ARK-Electronics/ARK_RTK_GPS/README.md

# DEPRECATED

This repository is no longer maintained. Its hardware files now live in [ark-hardware/ARK_RTK_GPS](https://github.com/ARK-Electronics/ark-hardware/tree/main/ARK_RTK_GPS).

Documentation: https://docs.arkelectron.com/products/gps/ark-rtk-gps
