ARK-Electronics/ARK_RTK_GPS/Hardware/Rev 3/ARK RTK GPS Rev 3 BOM.xlsx

LibRef | Designator | Quantity | Manufacturer | Mfr Part Number | Comment | Mfr Part Description | Footprint | Supplier | Supplier Part Number
30007 | C1, C2, C6, C19, C22, C23, C25, C27, C29, C32, C33, C34, C35 | 13 | Walsin Technology Corporation | 0402X104K250CT |  | CAP CER 0.1uF ±10% 25V X5R 0402 (1005 Metric) | CAP 0402/1005 | Digi-Key | 1292-1640-2-ND
30151 | C3, C5, C8, C17, C24, C30 | 6 | Murata | GRM155R61A225ME95D | 2.2uF | CAP CER 2.2uF ±20% 10V X5R 0402 (1005 Metric) | CAP 0402/1005 | Digi-Key | 490-10452-2-ND
30652 | C4, C13, C14, C20 | 4 | Samsung Electro-Mechanics | CL05A105KP5NNNC | 1uF | CAP CER 1uF ±10% 10V X5R 0402 (1005 Metric) | CAP 0402/1005 | Digi-Key | 1276-1076-1-ND
30418 | C7, C9, C10, C11, C12, C15, C16 | 7 | Samsung Electro-Mechanics | CL05A106MP8NUB8 | 10uF | CAP CER 10uF ±20% 10V X5R 0402 (1005 Metric) | CAP 0402/1005 | Digi-Key | 1276-6830-1-ND
30018 | C18, C31 | 2 | Samsung | CL05B103KA5NNNC |  | CAP CER 10000pF ±10% 25V X7R 0402 (1005 Metric) | CAP 0402/1005 | Digi-Key | 1276-1057-1-ND
31092 | C21 | 1 | Elna America | DSK-3R3H224U-HL | 220 mF | CAP 220 mF -20%, +80% 3.3V Coin, Wide Terminals - Opposite Sides | DSK-3R3H224U-HL | Digi-Key | 604-1020-2-ND
30302 | C26 | 1 | TDK Corporation | C1005X5R0J475K050BC | 4.7uF | CAP CER 4.7uF ±10% 6.3V X5R 0402 (1005 Metric) | CAP 0402/1005 | Digi-Key | 445-5947-1-ND
30502 | C28 | 1 | Samsung Electro-Mechanics | CL05C101JB5NNNC | 100pF | CAP CER 100pF ±5% 50V NPO 0402 (1005 Metric) | CAP 0402/1005 | Digi-Key | 1276-1025-1-ND
30765 | D1 | 1 | Nexperia USA Inc. | PESD1CAN-UX | PESD1CAN-UX | TVS DIODE 24V 50V SC70-3 | SOT65P210X110-3N | Digi-Key | 1727-1306-1-ND
30446 | D2 | 1 | Littelfuse Inc. | PESD0402-140 | PESD0402-140 | TVS DIODE 14V 40V 0402 | DIOC1005X04N 0402 | Digi-Key | PESD0402-140CT-ND
30628 | D3, D8 | 2 | Lite-On Inc. | LTST-C191KGKT | LTST-C191KGKT | Green 571nm LED Indication - Discrete 2V 0603 (1608 Metric) | LTST-C191TBKT | Digi-Key | 160-1446-1-ND
30022 | D4 | 1 | Nexperia USA Inc. | BAT54J,115 |  | DIODE SCHOTTKY 30V 200MA SOD323F | SOD323 | Digi-Key | 1727-4818-6-ND
30059 | D5, D7 | 2 | Lite-On Inc. | LTST-C194TBKT | LTST-C194TBKT | LED BLUE CLEAR SMD | LTST-C191TBKT | Digi-Key | 160-1837-2-ND
30943 | D6, D9 | 2 | Lite-On Inc. | LTST-C190KRKT | LTST-C190KRKT | LED RED CLEAR CHIP SMD | LTST-C191TBKT | Digi-Key | 160-1436-2-ND
30166 | D10, D11, D12, D13, D14, D15 | 6 | ON Semiconductor | ESD9C3.3ST5G |  | TVS DIODE 3.3VWM SOD923 | SOD-923 | Digi-Key | ESD9C3.3ST5GOSCT-ND
30106 | J1, J2 | 2 | JST Sales America Inc. | SM04B-GHS-TB(LF)(SN)- |  | CONN HEADER GH SIDE 4POS 1.25MM | SM04B-GHS | Digi-Key | 455-1566-1-ND
31030 | J3 | 1 | Molex | 0733910060 | 0733910060 | CONN SMA RCPT STR 50 OHM PCB | MOLEX_73391-0060 | Digi-Key | WM5543-ND
30085 | J4 | 1 | JST Sales America Inc. | SM06B-SRSS-TB(LF)(SN) |  | CONN HEADER SH 6POS SIDE 1MM TIN | SM06B-SRSS-TB(LF)(SN) | Digi-Key | 455-1806-1-ND
30548 | J5 | 1 | JST Sales America Inc. | SM03B-GHS-TB(LF)(SN) | SM03B-GHS-TB(LF)(SN) | Connector Header Surface Mount, Right Angle 3 position 0.049" (1.25mm) | SM03B-GHS | Digi-Key | 455-1565-1-ND
30445 | L1 | 1 | Murata Electronics North America | LQW15ANR12J00D | 120nH | INDUCTOR 120nH ±5% 110mA 0402 (1005 Metric) | Ind 0402/1005 | Digi-Key | 490-4091-1-ND
31111 | Q1, Q3, Q4, Q5 | 4 | Diodes Incorporated | DMN53D0L-7 | DMN53D0L-7 | MOSFET N-CH 50V 500MA SOT23 | SOT23 DIODES | Digi-Key | DMN53D0L-7DITR-ND
30108 | Q2 | 1 | Infineon Technologies | BSS223PWH6327XTSA1 |  | MOSFET P-CH 20V 390MA SOT-323 | INF-PG-SOT-323_L | Digi-Key | BSS223PWH6327XTSA1CT-ND
30327 | R2, R13, R15, R17, R34, R35 | 6 | Yageo | AC0402JR-070RL | 0 | RES 0 Ohm Jumper 1/16W 0402 (1005 Metric) | RESC0402(1005)_N | Digi-Key | 311-0.0LBCT-ND
30452 | R3 | 1 | Stackpole Electronics Inc | RMCF1210JT10R0 | 10 | RES 10 Ohm ±5% 1/2W 1210 (3225 Metric) | C1210_M | Digi-Key | RMCF1210JT10R0CT-ND
30956 | R4 | 1 | Stackpole Electronics Inc | RMCF0603FT120R |  | RES 120 Ohm ±1% 1/10W 0603 (1608 Metric) | RES603L | Digi-Key | RMCF0603FT120RTR-ND
30490 | R5 | 1 | Stackpole Electronics Inc | RMCF0402JT220R | 220 | RES 220 Ohm ±5% 1/16W 0402 (1005 Metric) | RESC0402(1005)_N | Digi-Key | RMCF0402JT220RCT-ND
30330 | R6 | 1 | Yageo | AC0402FR-072K2L | 2.2K | RES 2.2K Ohm ±1% 1/16W 0402 (1005 Metric) | RESC0402(1005)_N | Digi-Key | YAG3467CT-ND
30333 | R7, R8, R10, R16, R18, R20, R31, R32, R33, R36 | 10 | Yageo | AC0402JR-07100KL | 100K | RES 100K Ohm ±5% 1/16W 0402 (1005 Metric) | RESC0402(1005)_N | Digi-Key | YAG3515CT-ND
30207 | R9, R26, R27, R28, R29 | 5 | Yageo | RC0402FR-075K1L |  | RES 5.1K Ohm ±1% 1/16W 0402 (1005 Metric) | RESC0402(1005)_N | Digi-Key | 311-5.10KLRCT-ND
30328 | R11, R19, R21, R30 | 4 | Yageo | RC0402FR-07150RL | 150 | RES 150 Ohm ±1% 1/16W 0402 (1005 Metric) | RESC0402(1005)_N | Digi-Key | 311-150LRTR-ND
30681 | R14, R22 | 2 | Yageo | RC0402FR-07330RL | 330 | RES 330 Ohm ±1% 1/16W 0402 (1005 Metric) | RESC0402(1005)_N | Digi-Key | 311-330LRCT-ND
30838 | R23, R24 | 2 | Stackpole Electronics Inc | RMCF0402FT604R | 604 | RES 604 Ohm ±1% 1/16W 0402 (1005 Metric) | RESC0402(1005)_N | Digi-Key | RMCF0402FT604RCT-ND
31020 | S1 | 1 | C&ampK | PTS 647 SK38 SMTR2 LFS | PTS 647 SK38 SMTR2 LFS | TACT 4.5 X 4.5, 3.8 MM H, 2.5N, | PTS 647 SK38 SMTR2 LFS | Digi-Key | PTS647SK38SMTR2LFSTR-ND
30093 | SP1 | 1 | Soberton Inc. | ST-03CH | ST-03CH | AUDIO MAGNETIC XDCR 4-6V SMD | ST-03CH | Digi-Key | 433-1007-1-ND
30095 | U1 | 1 | NXP USA Inc. | TJA1051TK/3,118 | TJA1051TK/3,118 | IC CAN TRANSEIVER HS 8HVSON | 8DFN_3x3 | Digi-Key | 568-8686-1-ND
30489 | U2 | 1 | Nexperia USA Inc. | PMBT3906VS,115 | PMBT3906VS,115 | TRANS 2PNP 40V 0.2A SOT666 | SOT666 | Digi-Key | 1727-5179-1-ND
30951 | U3 | 1 | Texas Instruments | LM66100DCKR |  | IC OR CTRLR IDEAL DIODE SC70-6 | SOT65P210X110-6N | Digi-Key | 296-53541-2-ND
30451 | U4, U5 | 2 | ON Semiconductor | NCV8705MT33TCG | NCV8705MT33TCG | IC REG LINEAR 3.3V 500MA 6WDFN | WDFN6 2x2, 0.65P | Digi-Key | NCV8705MT33TCGOSCT-ND
30440 | U6 | 1 | U-Blox | ZED-F9P-02B | ZED-F9P-02B | MOD RF RECEIVER GNSS 54LGA | Ublox ZED-F9P | Digi-Key | 672-ZED-F9P-02BTR-ND
30579 | U7 | 1 | STMicroelectronics | STM32F412CEU6 | STM32F412CEU6 | ARM® Cortex®-M4 STM32F4 Microcontroller IC 32-Bit 100MHz 512KB (512K x 8) FLASH 48-UFQFPN (7x7) | UFQFPN48 | Digi-Key | 497-18545-ND
31087 | U8 | 1 | IQD Frequency Products | LFSPXO072801REEL | LFSPXO072801REEL | XTAL OSC XO 8.0000MHZ HCMOS SMD | LFSPXO072801REEL | Digi-Key | 1923-1681-2-ND
31021 | U9 | 1 | TDK InvenSense | ICM-42688-P | ICM-42688-P | MOTION SENSOR | ICM-42688-P | Digi-Key | 1428-ICM-42688-PTR-ND
30801 | U10 | 1 | Bosch Sensortec | BMM150 | BMM150 | SENSOR FLIPCORE/HALL SPI 12WLCSP | XDCR_BMM150 | Digi-Key | 828-1044-1-ND
30798 | U11 | 1 | Bosch Sensortec | BMP388 | BMP388 | SENSOR PRESSURE ABS | BMP388 | Digi-Key | 828-1079-1-ND
