ARK-Electronics/ARK_RTK_GPS/Case/Top Case 0.5.stl

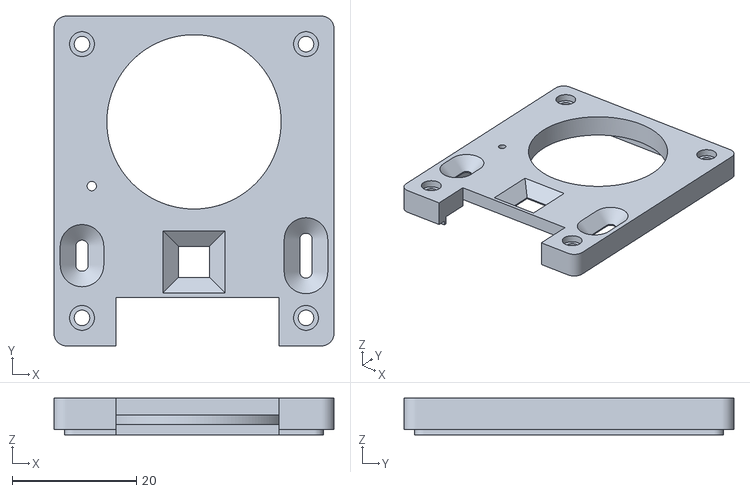
[picture p1: CAD file, 2021-12-04]
Case/Top Case 0.5.stl
45.0 x 53.0 x 5.90
