ARK-Electronics/ARK_RTK_GPS/Case/Bottom Case 0.5.stl

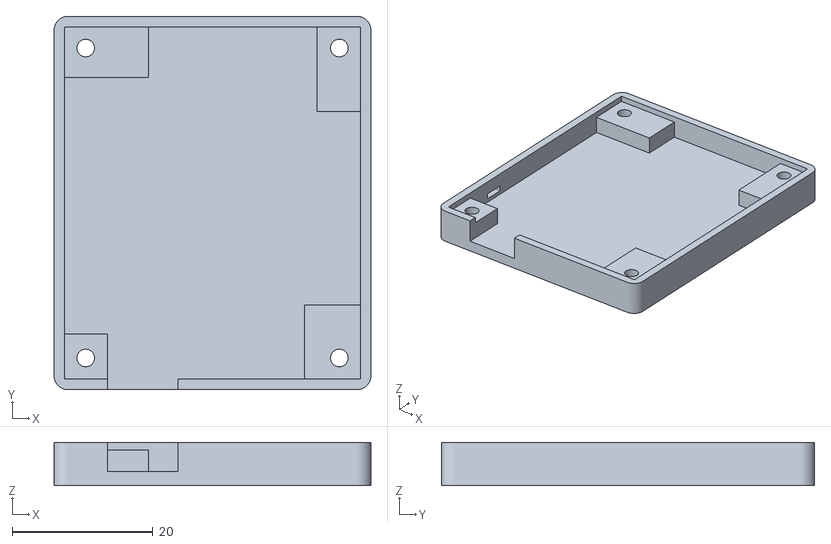
[picture p2: CAD file, 2021-12-04]
Case/Bottom Case 0.5.stl
45.0 x 53.0 x 6.16
