ARK-Electronics/ARK_RTK_GPS/Hardware/Rev 3/ARK RTK GPS Rev 3 Schematic.PDF

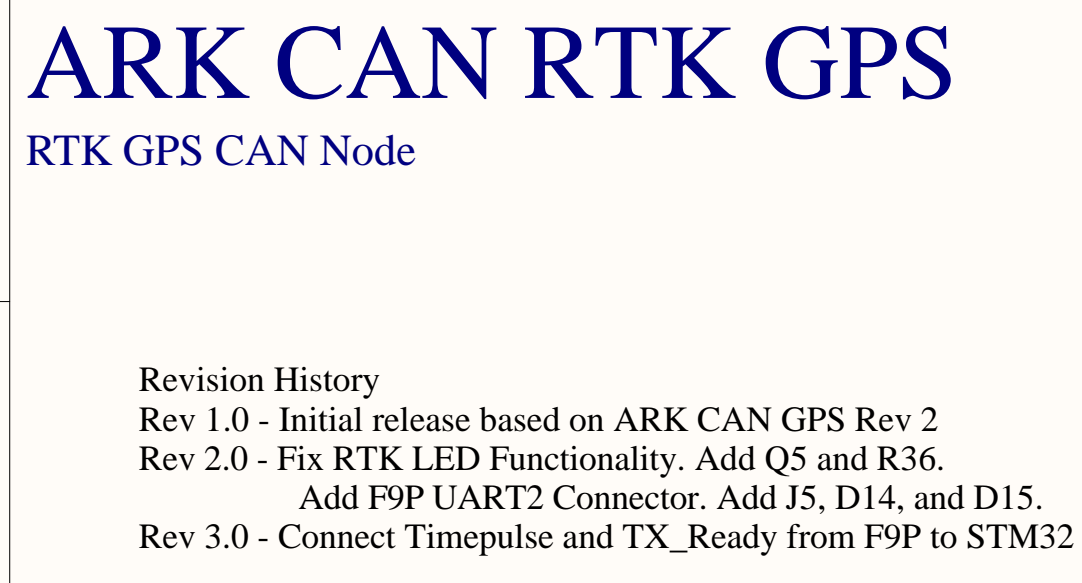
[picture p3: page 1]

ARK CAN RTK GPS

RTK GPS CAN Node

Revision History
Rev 1.0 - Initial release based on ARK CAN GPS Rev 2
Rev 2.0 - Fix RTK LED Functionality. Add Q5 and R36.

Add F9P UART2 Connector. Add J5, D14, and D15.

Rev 3.0 - Connect Timepulse and TX_Ready from F9P to STM32

Project Title:

Revision: | Variant: Production

Date: 4/29/2022 | Time: 1:46:38 PM | Size: LEGAL | Sheet of

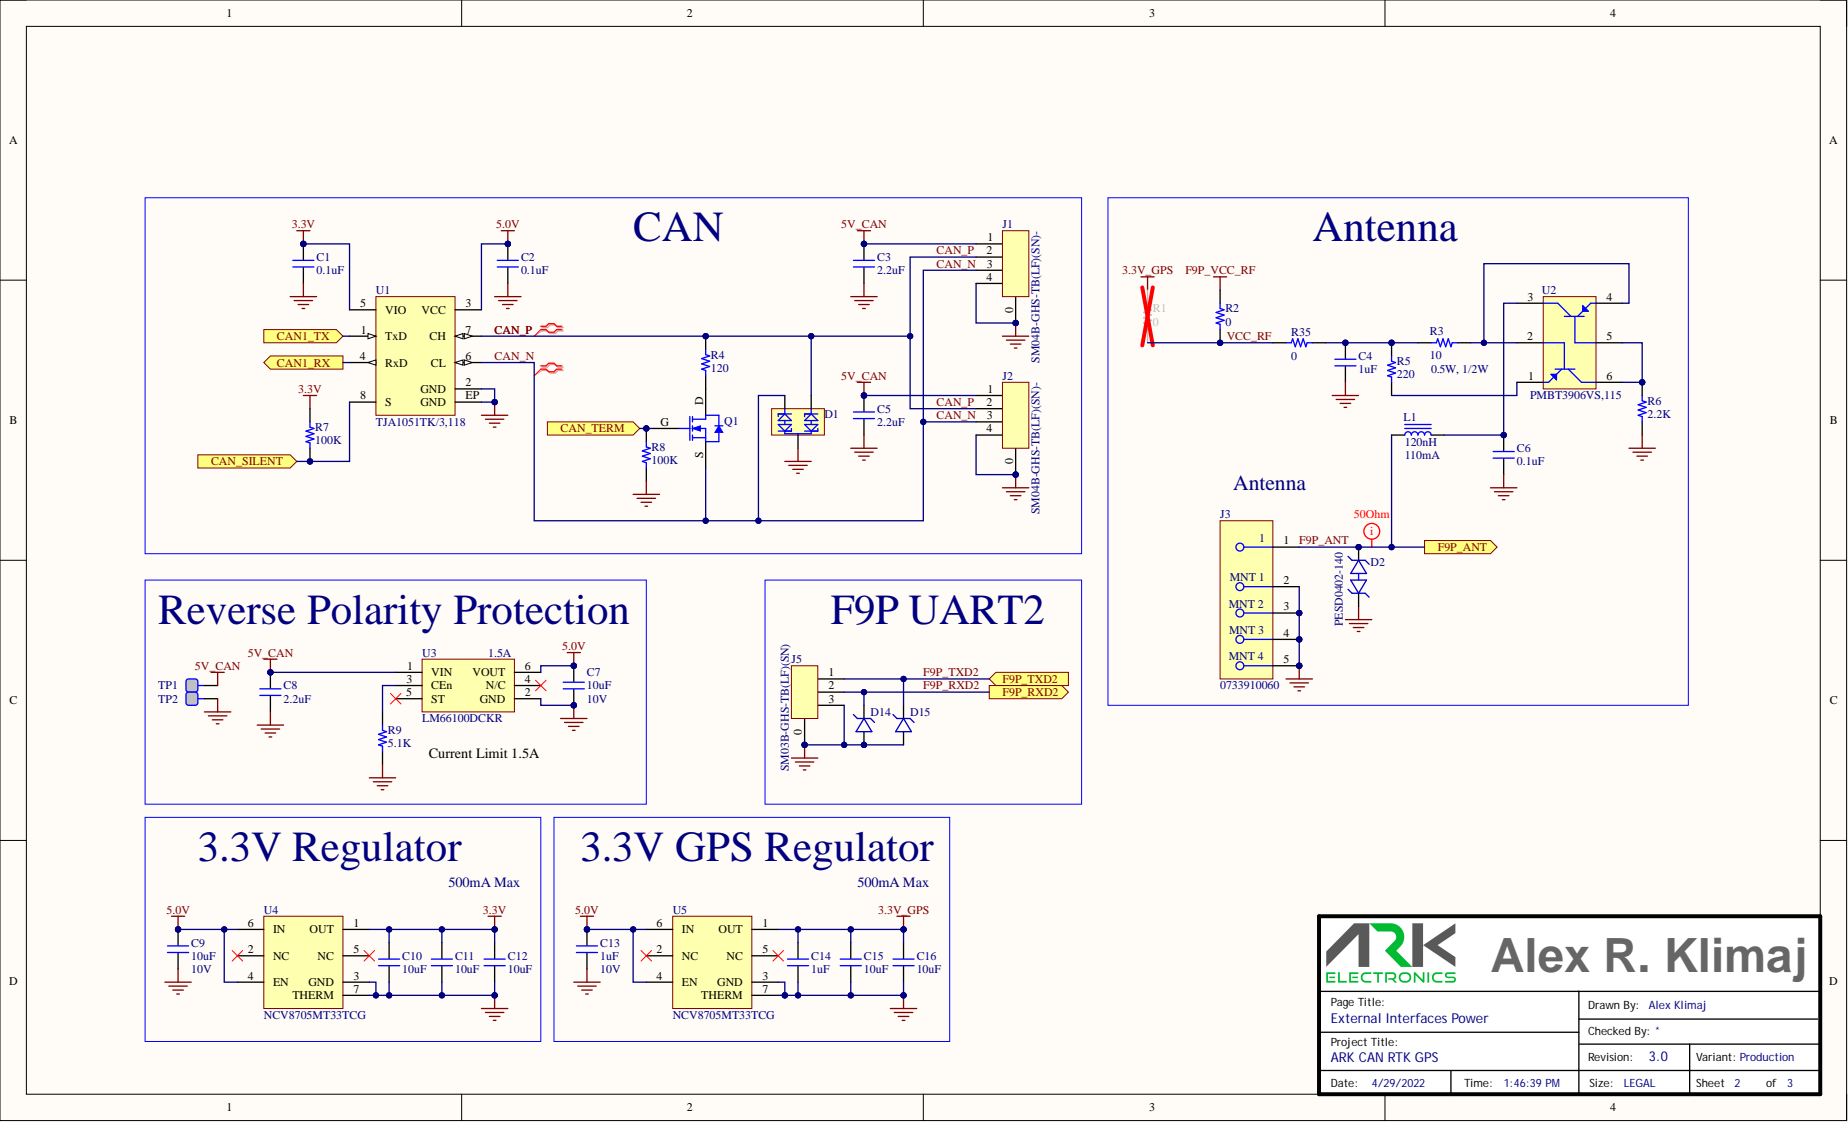
[picture p4: page 2]

SM04B-GHS-TB(LF)(SN)-

CAN_N | 3

SM03B-GHS-TB(LF)(SN) J5

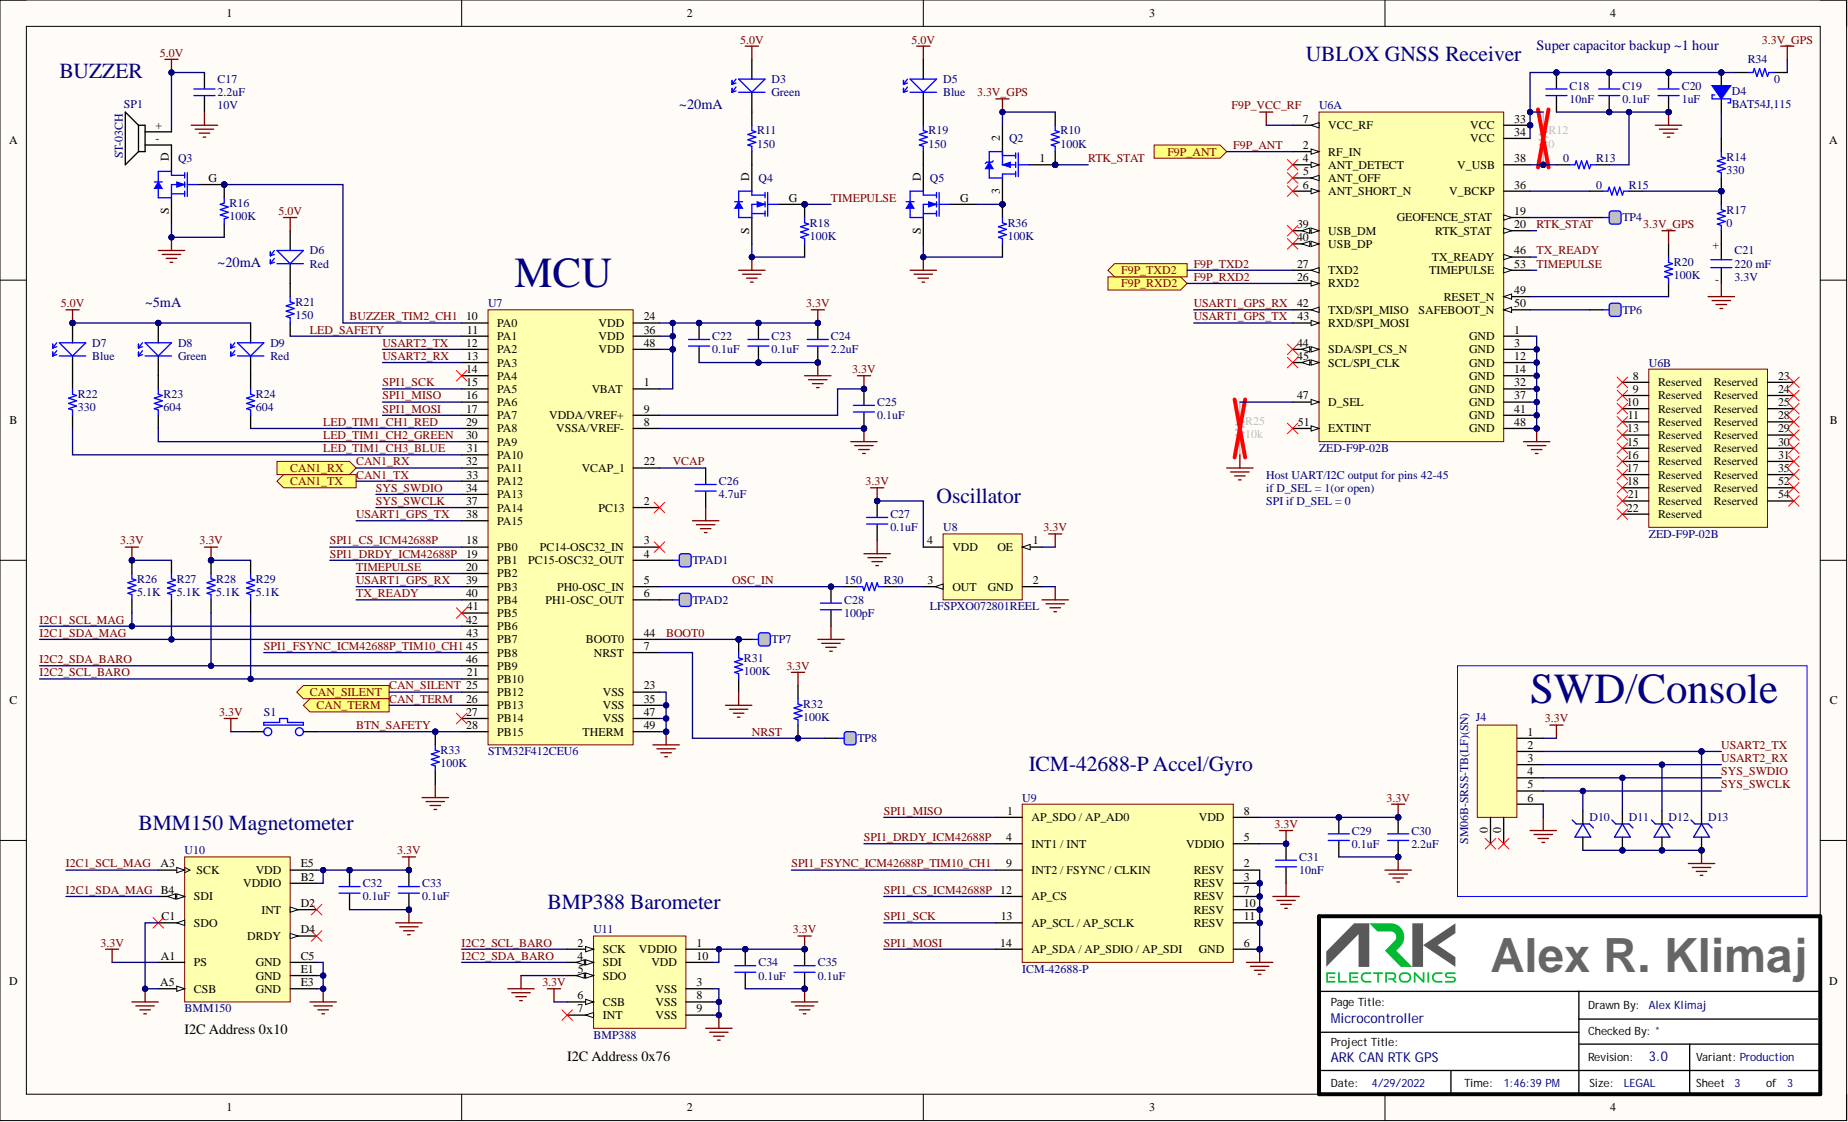
[picture p5: page 3]

Super capacitor backup ~1 hour

Host UART/I2C output for pins 42-45
if D_SEL = 1(or open)
SPI if D_SEL = 0

SM06B-SRSS-TB(LF)(SN)
