ARK-Electronics/ARK_RTK_GPS/Hardware/Rev 1/ARK RTK GPS Rev 1 Schematic.PDF

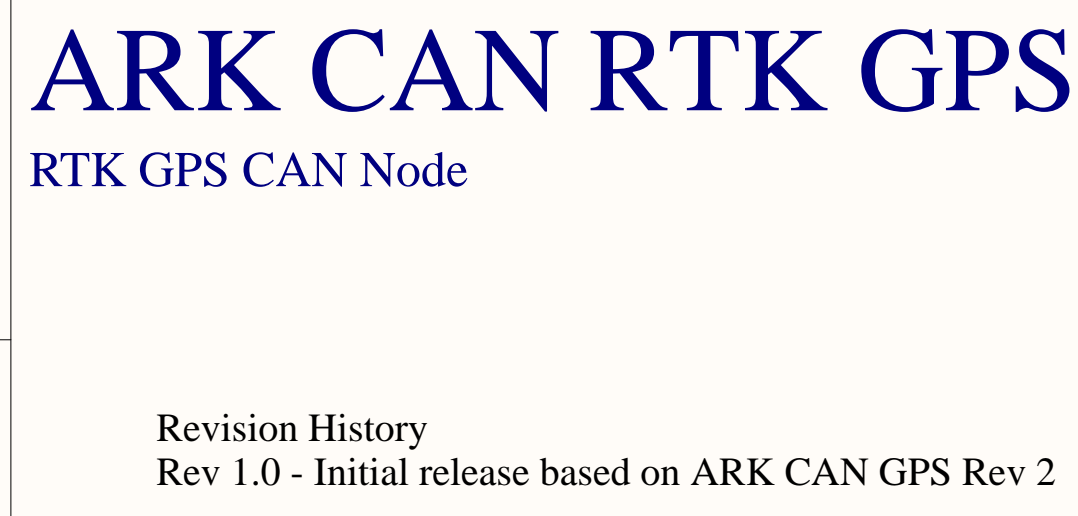
[picture p6: page 1]

ARK CAN RTK GPS

RTK GPS CAN Node

Revision History
Rev 1.0 - Initial release based on ARK CAN GPS Rev 2

Project Title:

Revision: | Variant: Production

Date: 9/13/2021 | Time: 11:41:00 AM | Size: LEGAL | Sheet of

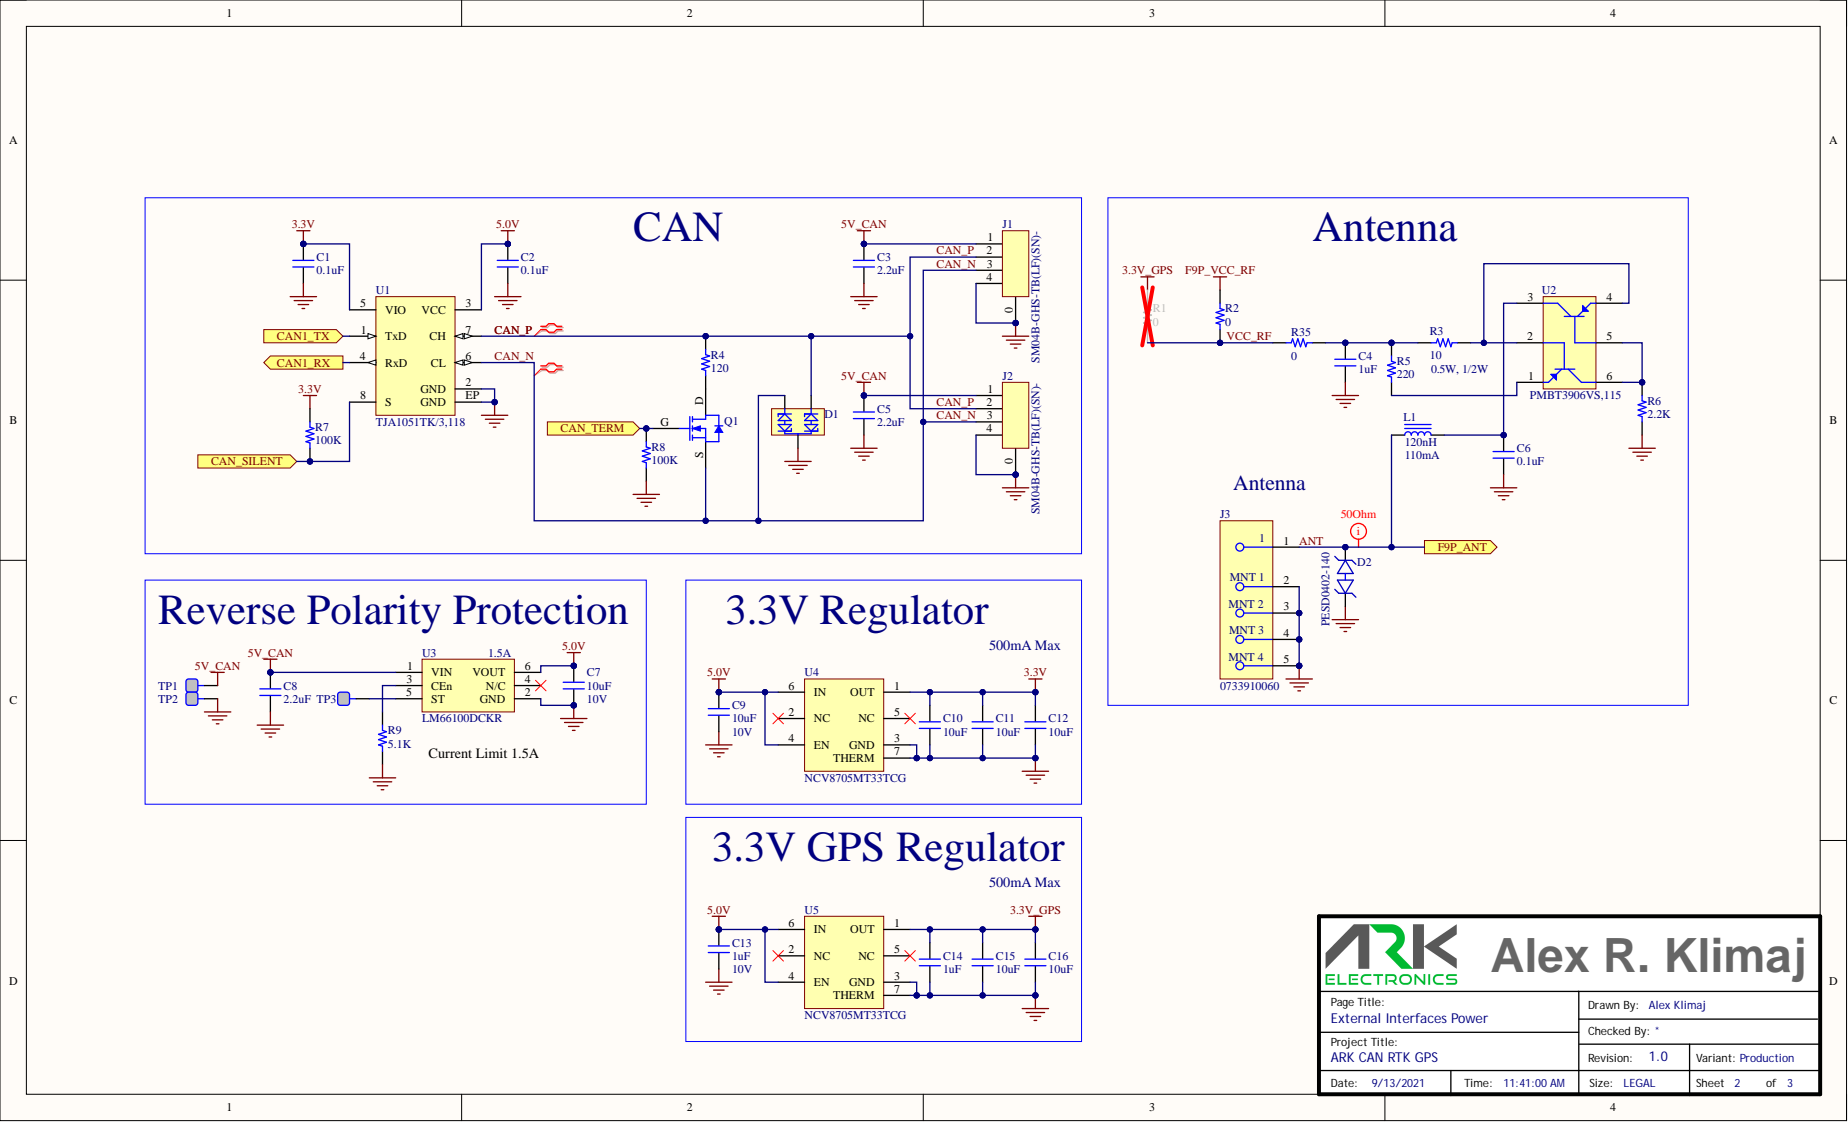
[picture p7: page 2]

SM04B-GHS-TB(LF)(SN)-

CAN_N | 3

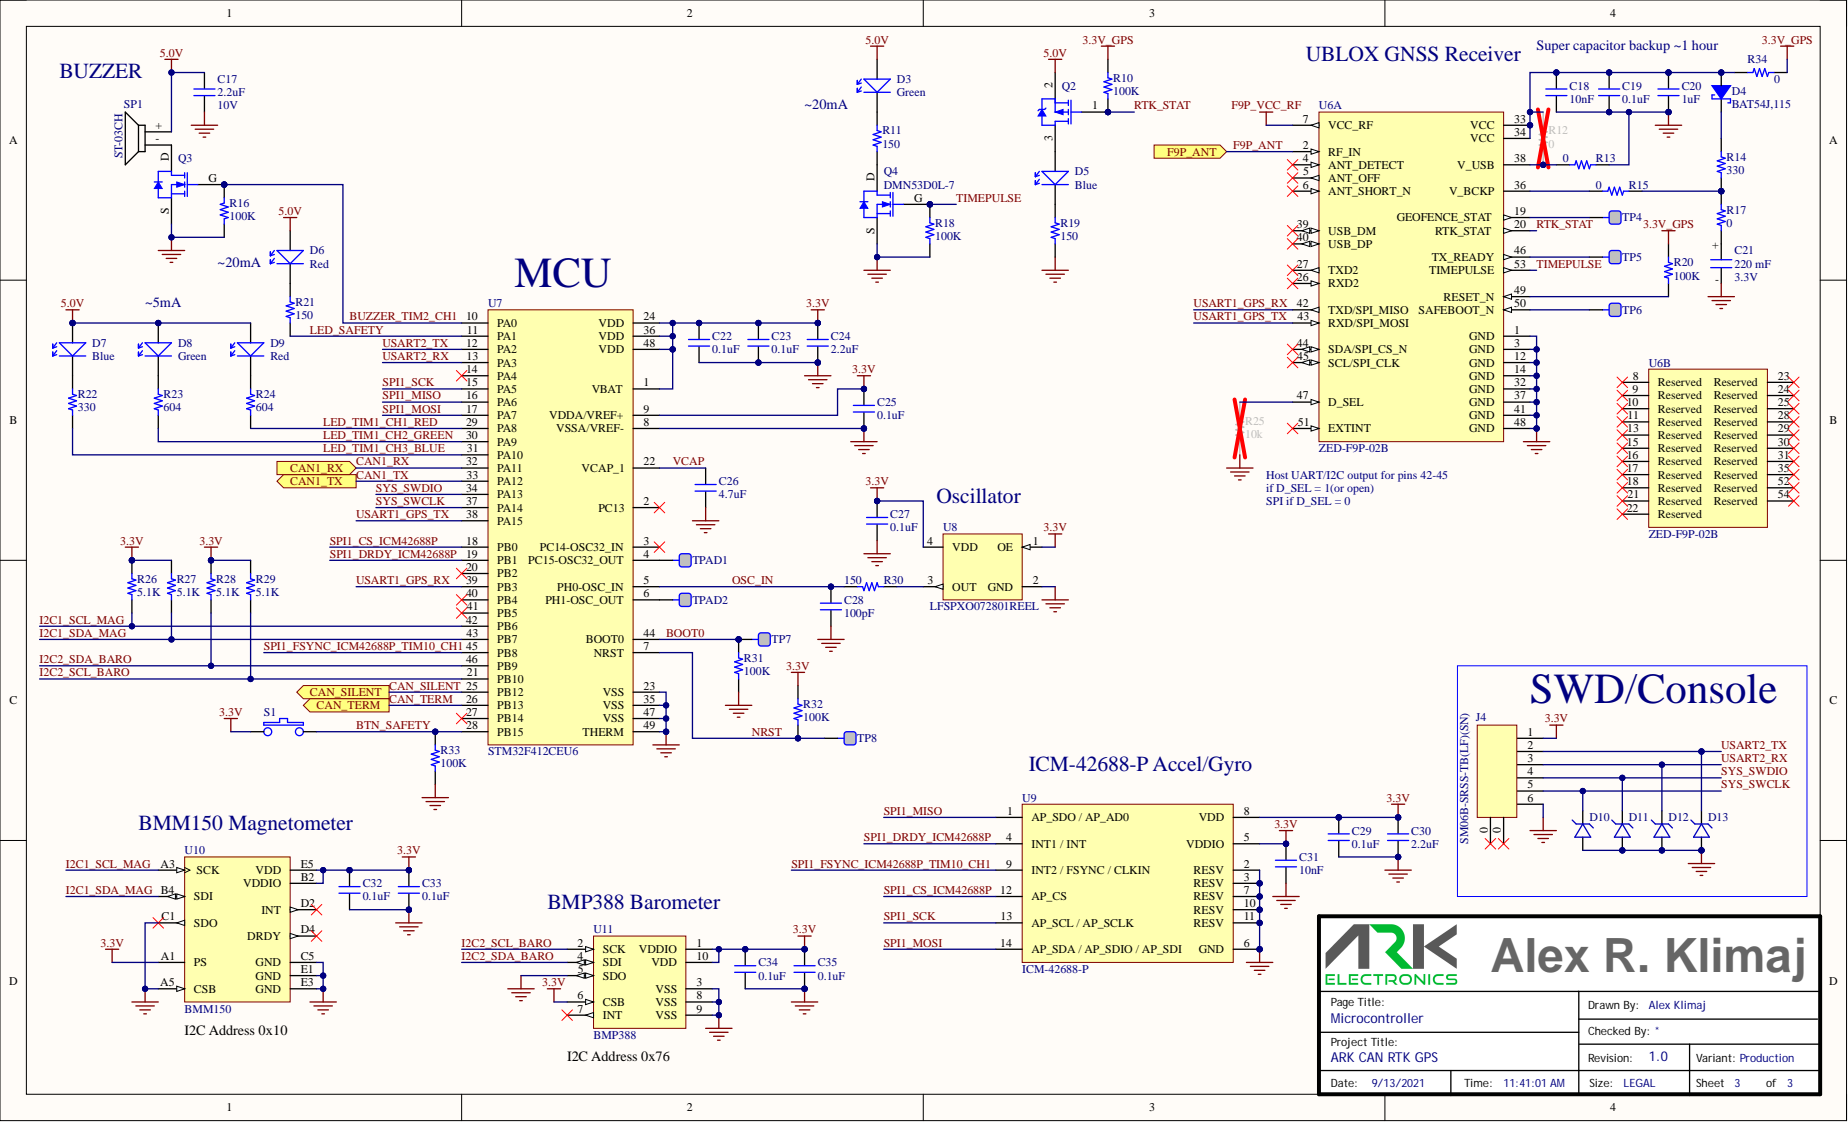
[picture p8: page 3]

Super capacitor backup ~1 hour

Host UART/I2C output for pins 42-45
if D_SEL = 1(or open)
SPI if D_SEL = 0

SM06B-SRSS-TB(LF)(SN)
