ARK-Electronics/ARK_RTK_GPS/(commit log)

2021-11-29 Rev 1 and 2
    [ARK RTK GPS Rev 1 BOM.xlsx, ARK RTK GPS Rev 2 BOM.xlsx]
2021-12-02 Add case files rev 0.2
    [Bottom Case 0.2.stl, Top Case 0.2.stl]
2021-12-04 Update case
    [Bottom Case 0.2.stl, Bottom Case 0.5.stl, Top Case 0.2.stl, Top Case 0.5.stl]
2022-10-03 Add Rev 3
    Rev 3 connects the timepulse signal from the GPS to the MCU.
    [ARK RTK GPS Rev 3 BOM.xlsx]
